oxidecomputer/hw-gimletlet-nic/nic2.kicad_pcb

## KiCad design nic2.kicad_pcb (2023-02-28)

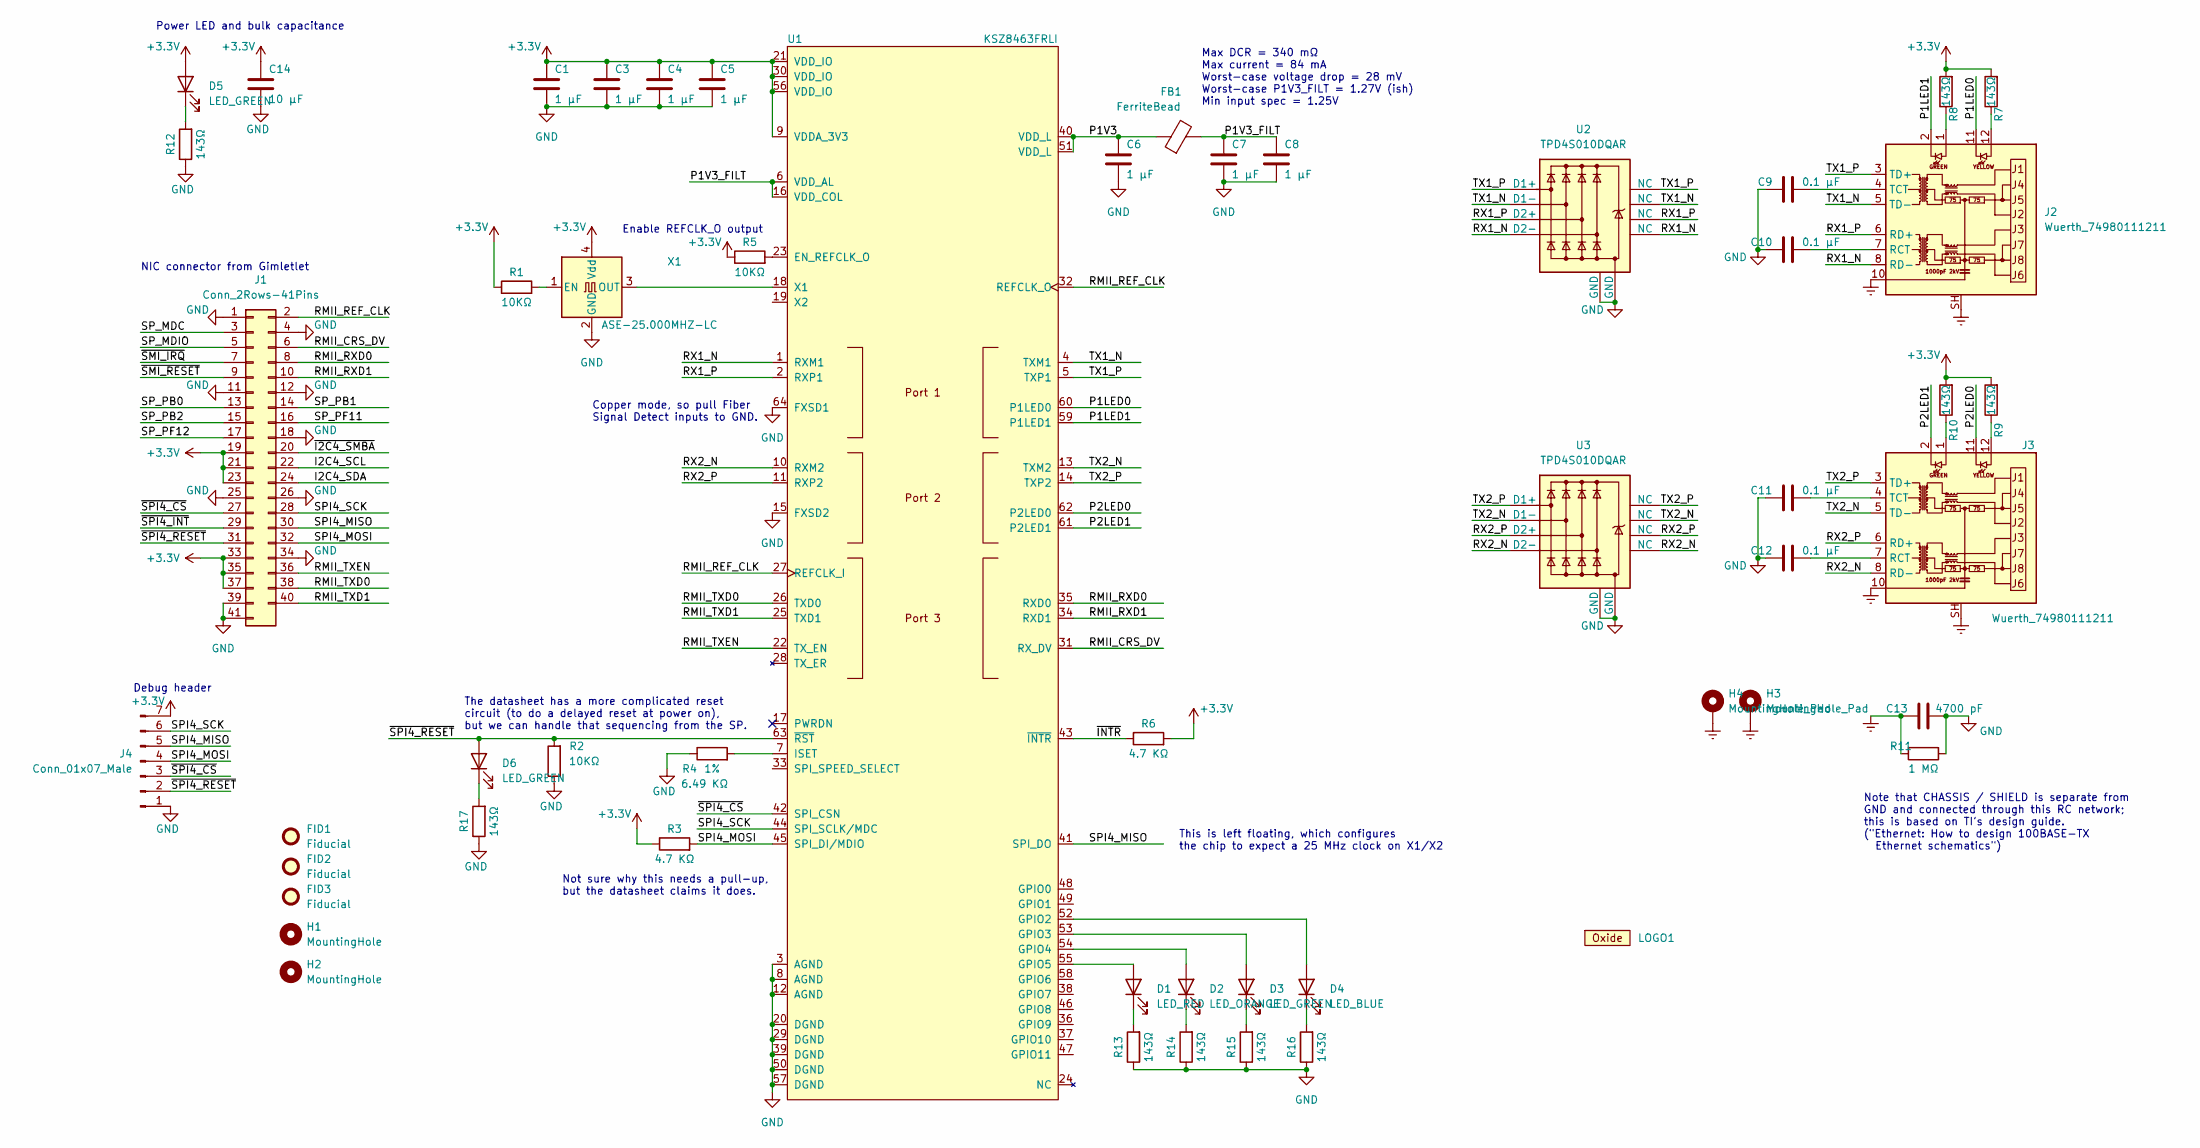
[picture p2: schematic nic2.kicad_sch, Gimletlet NIC 2]

Parts:
C1, C3, C4, C5, C6, C7, C8: 1 µF; C_0402_1005Metric; MPN C0402C105K9PAC7800
C9, C10, C11, C12: 0.1 µF; C_0402_1005Metric; MPN C0402C104K9RAC7867
C13: 4700 pF; C_0402_1005Metric; MPN C0402C472K3RAC7867
C14: 10 µF; C_0805_2012Metric; MPN C0805C106K9RAC7800
D1: LED_RED; LED_0402_1005Metric; MPN XZMDK68W-2
D2: LED_ORANGE; LED_0402_1005Metric; MPN XZMOK68W-2
D3, D5, D6: LED_GREEN; LED_0402_1005Metric; MPN XZVG68W-2
D4: LED_BLUE; LED_0402_1005Metric; MPN VLMB1500-GS08
FB1: FerriteBead; R_0402_1005Metric; MPN BLM15AX601SN1D
FID1, FID2, FID3: Fiducial; Fiducial_0.75mm_Mask1.5mm
H1, H2: MountingHole; MountingHole_3.2mm_M3
H3, H4: MountingHole_Pad; MountingHole_3.2mm_M3_DIN965_Pad
J1: Conn_2Rows-41Pins; DF9-41P-1V; MPN DF9-41P-1V(69)
J2, J3: Wuerth_74980111211; RJ45_Wuerth_74980111211_Horizontal; MPN 74980111211
J4: Conn_01x07_Male; PinHeader_1x07_P2.54mm_Vertical
LOGO1: LOGO; OXIDE_Wordmark
R1, R2, R5: 10KΩ; R_0402_1005Metric; MPN CRG0402F10K
R3, R6: 4.7 KΩ; R_0402_1005Metric; MPN CRG0402F4K7
R4: 6.49 KΩ; R_0402_1005Metric; MPN RC0402FR-076K49L
R7, R8, R9, R10, R12, R13, R14, R15, R16, R17: 143Ω; R_0402_1005Metric; MPN RC0402FR-07143RL
R11: 1 MΩ; R_0402_1005Metric; MPN CRG0402F1M0
U1: KSZ8463FRLI; LQFP-64_10x10mm_P0.5mm; MPN KSZ8463FRLI
U2, U3: TPD4S010DQAR; USON-10_2.5x1.0mm_P0.5mm; MPN TPD4S010DQAR
X1: ASE-25.000MHZ-LC; Oscillator_SMD_Abracon_ASE-4Pin_3.2x2.5mm; MPN ASE-25.000MHZ-LC-T

Connections:
+3V3: C1.2, C3.2, C4.2, C5.2, C14.2, D5.2 (A), J1.19, J1.21, J1.23, J1.33, J1.35, J1.37, J4.7, R1.1, R3.1, R5.1, R6.2, R7.2, R8.2, R9.2, R10.2, U1.9 (VDDA_3V3), U1.21 (VDD_IO), U1.30 (VDD_IO), U1.56 (VDD_IO), X1.4 (Vdd)
/I2C4_SCL: J1.22
/I2C4_SDA: J1.24
/P1LED0: J2.11, U1.60 (P1LED0)
/P1LED1: J2.2, U1.59 (P1LED1)
/P1V3: C6.2, FB1.1, U1.40 (VDD_L), U1.51 (VDD_L)
/P1V3_FILT: C7.2, C8.2, FB1.2, U1.6 (VDD_AL), U1.16 (VDD_COL)
/P2LED0: J3.11, U1.62 (P2LED0)
/P2LED1: J3.2, U1.61 (P2LED1)
/RMII_CRS_DV: J1.6, U1.31 (RX_DV)
/RMII_REF_CLK: J1.2, U1.27 (REFCLK_I), U1.32 (REFCLK_O)
/RMII_RXD0: J1.8, U1.35 (RXD0)
/RMII_RXD1: J1.10, U1.34 (RXD1)
/RMII_TXD0: J1.38, U1.26 (TXD0)
/RMII_TXD1: J1.40, U1.25 (TXD1)
/RMII_TXEN: J1.36, U1.22 (TX_EN)
/RX1_N: J2.8 (RD-), U1.1 (RXM1), U2.5 (D2-), U2.6 (NC)
/RX1_P: J2.6 (RD+), U1.2 (RXP1), U2.4 (D2+), U2.7 (NC)
/RX2_N: J3.8 (RD-), U1.10 (RXM2), U3.5 (D2-), U3.6 (NC)
/RX2_P: J3.6 (RD+), U1.11 (RXP2), U3.4 (D2+), U3.7 (NC)
/SPI4_MISO: J1.30, J4.5, U1.41 (SPI_DO)
/SPI4_MOSI: J1.32, J4.4, R3.2, U1.45 (SPI_DI/MDIO)
/SPI4_SCK: J1.28, J4.6, U1.44 (SPI_SCLK/MDC)
/SP_MDC: J1.3
/SP_MDIO: J1.5
/SP_PB0: J1.13
/SP_PB1: J1.14
/SP_PB2: J1.15
/SP_PF11: J1.16
/SP_PF12: J1.17
/TX1_N: J2.5 (TD-), U1.4 (TXM1), U2.2 (D1-), U2.9 (NC)
/TX1_P: J2.3 (TD+), U1.5 (TXP1), U2.1 (D1+), U2.10 (NC)
/TX2_N: J3.5 (TD-), U1.13 (TXM2), U3.2 (D1-), U3.9 (NC)
/TX2_P: J3.3 (TD+), U1.14 (TXP2), U3.1 (D1+), U3.10 (NC)
/~I2C4_SMBA: J1.20
/~INTR: R6.1, U1.43 (~INTR)
/~SMI_IRQ: J1.7
/~SMI_RESET: J1.9
/~SPI4_CS: J1.27, J4.3, U1.42 (SPI_CSN)
/~SPI4_INT: J1.29
/~SPI4_RESET: D6.2 (A), J1.31, J4.2, R2.2, U1.63 (~RST)
Earth: C13.2, H3.1, H4.1, J2.10, J2.SH, J3.10, J3.SH, R11.2
GND: C1.1, C3.1, C4.1, C5.1, C6.1, C7.1, C8.1, C9.2, C10.2, C11.2, C12.2, C13.1, C14.1, J1.1, J1.4, J1.11, J1.12, J1.18, J1.25, J1.26, J1.34, J1.39, J1.41, J4.1, R2.1, R4.1, R11.1, R12.1, R13.1, R14.1, R15.1, R16.1, R17.1, U1.3 (AGND), U1.8 (AGND), U1.12 (AGND), U1.15 (FXSD2), U1.20 (DGND), U1.29 (DGND), U1.39 (DGND), U1.50 (DGND), U1.57 (DGND), U1.64 (FXSD1), U2.3 (GND), U2.8 (GND), U3.3 (GND), U3.8 (GND), X1.2 (GND)
unnamed: C9.1, J2.4 (TCT)
unnamed: C10.1, J2.7 (RCT)
unnamed: C11.1, J3.4 (TCT)
unnamed: C12.1, J3.7 (RCT)
unnamed: D1.1 (K), R13.2
unnamed: D1.2 (A), U1.55 (GPIO5)
unnamed: D2.1 (K), R14.2
unnamed: D2.2 (A), U1.54 (GPIO4)
unnamed: D3.1 (K), R15.2
unnamed: D3.2 (A), U1.53 (GPIO3)
unnamed: D4.1 (K), R16.2
unnamed: D4.2 (A), U1.52 (GPIO2)
unnamed: D5.1 (K), R12.2
unnamed: D6.1 (K), R17.2
unnamed: J2.1, R8.1
unnamed: J2.12, R7.1
unnamed: J3.1, R10.1
unnamed: J3.12, R9.1
unnamed: R1.2, X1.1 (EN)
unnamed: R4.2, U1.7 (ISET)
unnamed: R5.2, U1.23 (EN_REFCLK_O)
unnamed: U1.18 (X1), X1.3 (OUT)

Notes on the sheet:
Note that CHASSIS / SHIELD is separate from GND and connected through this RC network; this is based on TI's design guide. ("Ethernet: How to design 100BASE-TX Ethernet schematics")
Enable REFCLK_O output
The datasheet has a more complicated reset circuit (to do a delayed reset at power on), but we can handle that sequencing from the SP.
Not sure why this needs a pull-up, but the datasheet claims it does.
Debug header
Copper mode, so pull Fiber Signal Detect inputs to GND.
Max DCR = 340 mΩ Max current = 84 mA Worst-case voltage drop = 28 mV Worst-case P1V3_FILT = 1.27V (ish) Min input spec = 1.25V
This is left floating, which configures the chip to expect a 25 MHz clock on X1/X2
NIC connector from Gimletlet
Power LED and bulk capacitance

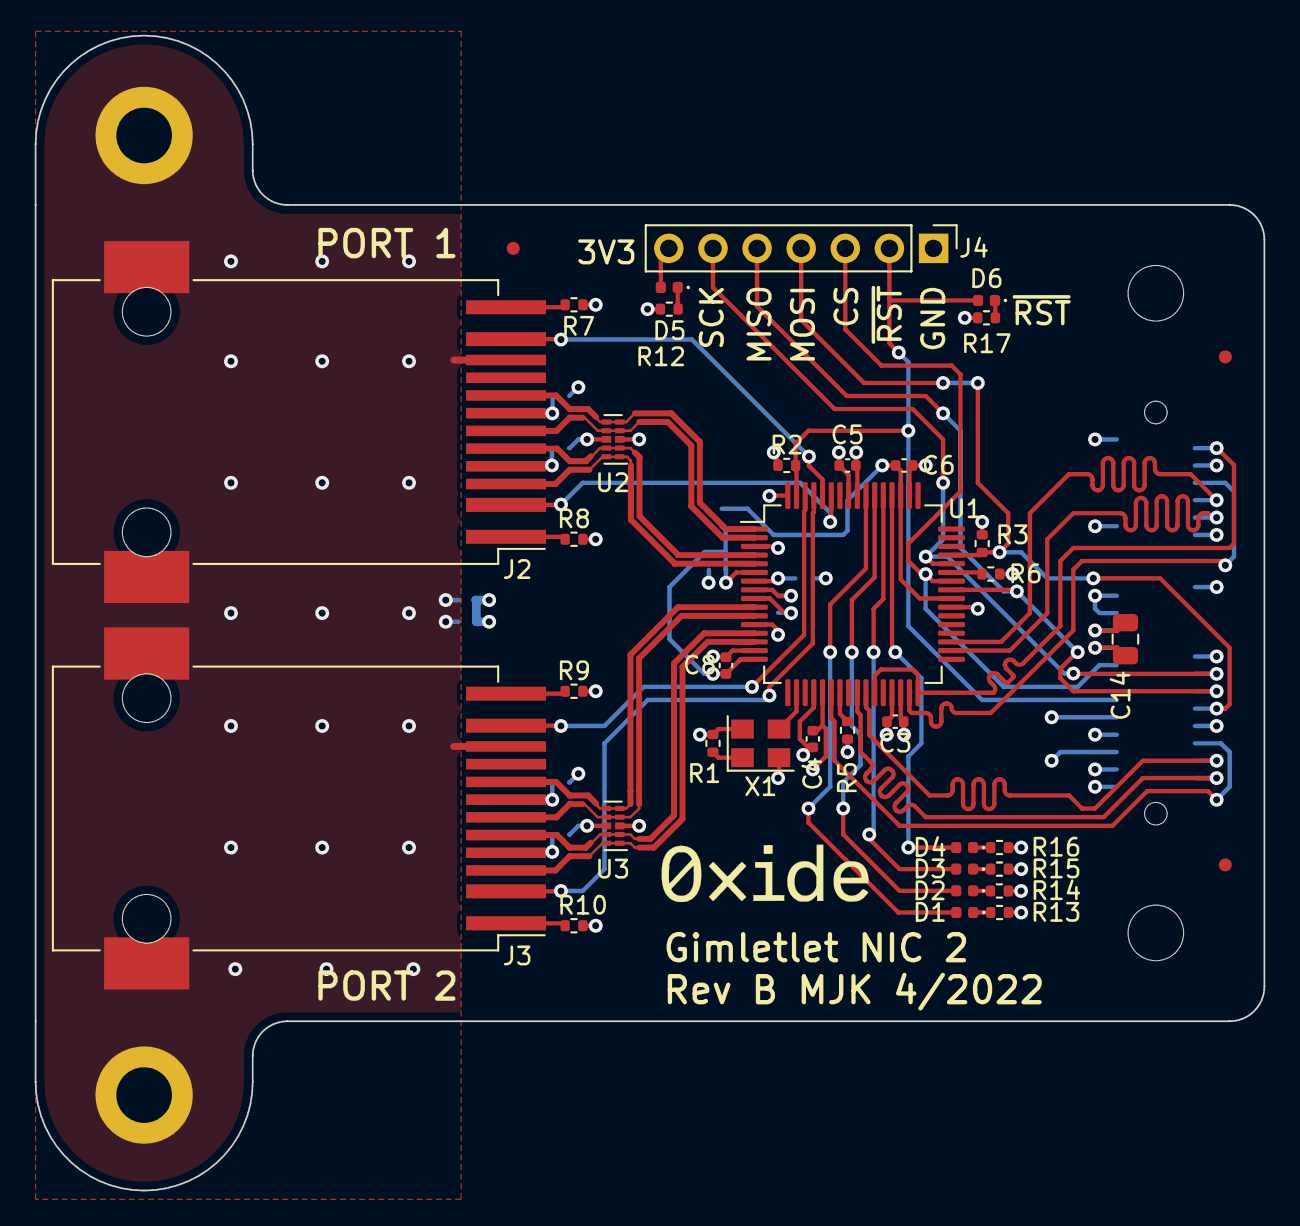
[picture p3: board nic2.kicad_pcb from above]

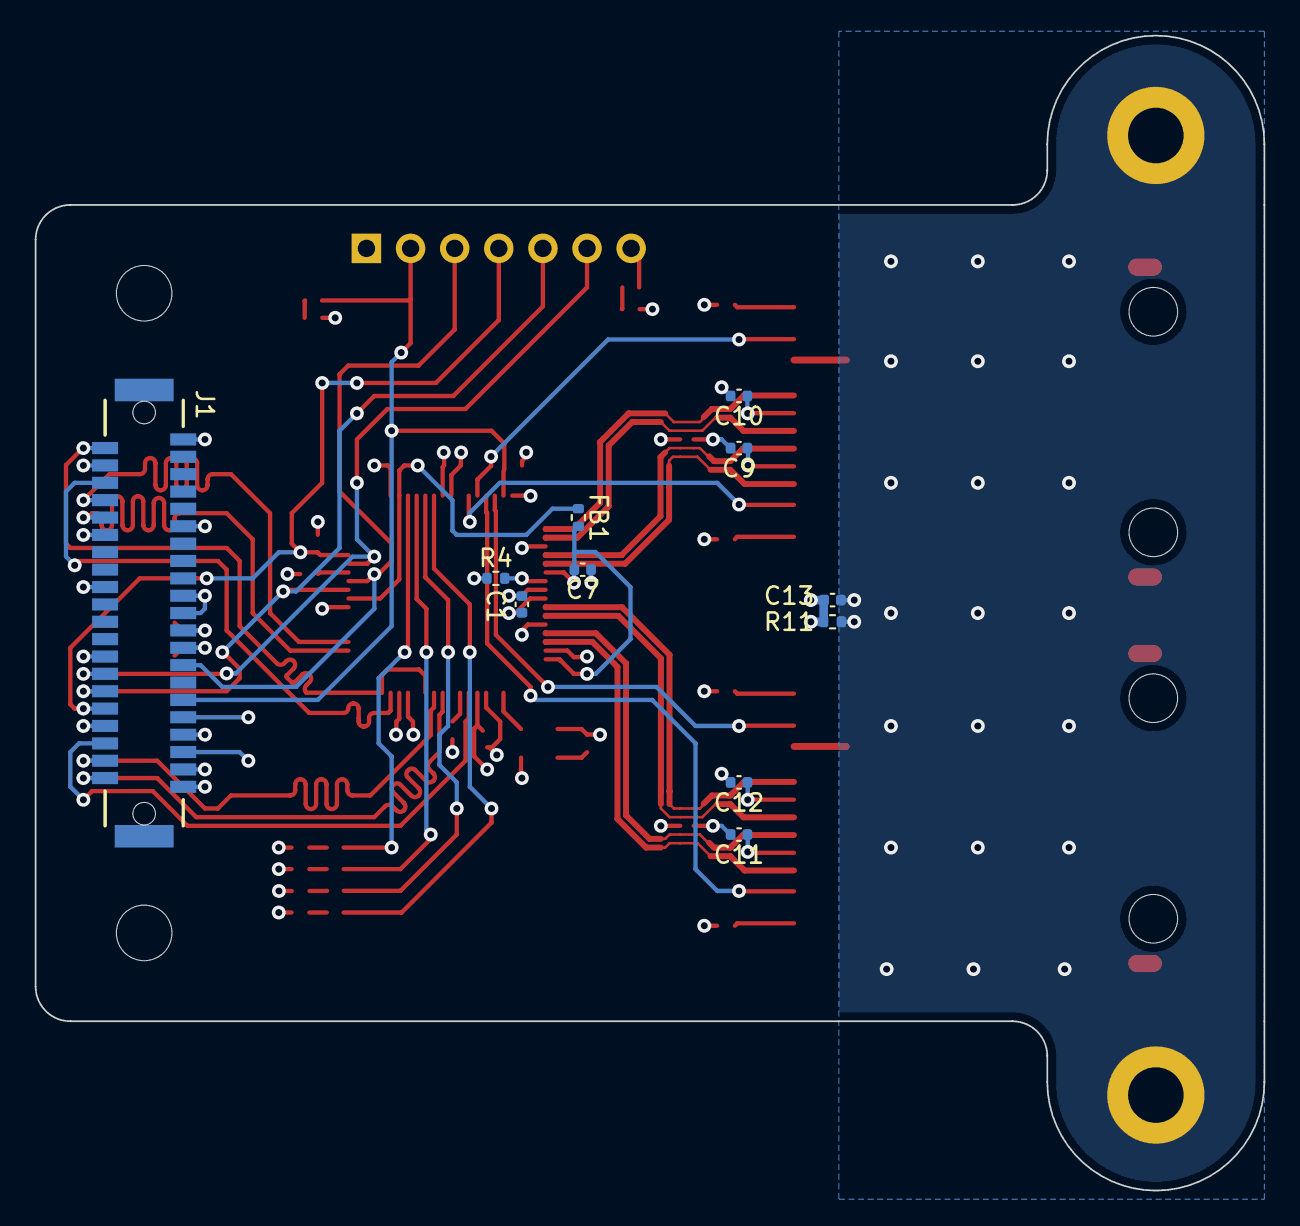
[picture p4: board nic2.kicad_pcb from below]

Board: 4 copper layers, 70.8 x 66.5 mm, 53 parts (11 on the bottom side), 52 nets.
